gkgk0119gmail-arch/guardian-tron/sw/jetson_stack/docs/CARLA_SIL.md

# The gatekeeper in CARLA, before it went on the car

Before there was a board, we drove the gatekeeper in [CARLA](https://carla.org/): a
simulated car with a 64-channel LiDAR, the same 15-byte CMD frames at 100 Hz, and an
attacker injecting steering commands into the link. The point was to answer one question
without risking a real vehicle — **does this veto logic actually stop an attack, and what
happens when it is not there?**

The simulator settled the *decision*. The board later settled the *timing*: the same logic
running on μT-Kernel 3.0 on the STM32N6570-DK, measured with the DWT cycle counter at
1.25 ns resolution ([test report](../../docs/test_report.md)).

Every counter in the screenshots below is measured output from those runs — approvals,
vetoes, collisions and lane departures were counted by the simulation, not drawn by hand.

## Reading the screenshots

The on-screen HUD is in Korean, because it was our working tool. By position:

| Where | What it shows |
|---|---|
| Top-left box | the scenario, whether the gatekeeper is enabled, and the simulation time |
| Top-right badge | the verdict at that instant — green APPROVE, red VETO → FAILSAFE, red "attack passes" when the gatekeeper is disabled, amber "inside the envelope" |
| Line under the badge | steering **commanded** by the AI → steering **applied** after the gatekeeper, and the veto reason when there is one |
| Upper-left stats | speed, lateral offset from the lane centre, LiDAR points per frame, vehicles detected, cumulative approved / vetoed, collisions / lane departures |
| Lower-left list | detected vehicles by distance, with the number of LiDAR points on each |
| Coloured points | height above ground; cyan is the road surface |
| Green box / red box | a vehicle found in the point cloud / the ego vehicle |
| Inset, bottom right | RGB chase camera |
| Banner across the inset | the attack currently being injected |

## Normal driving

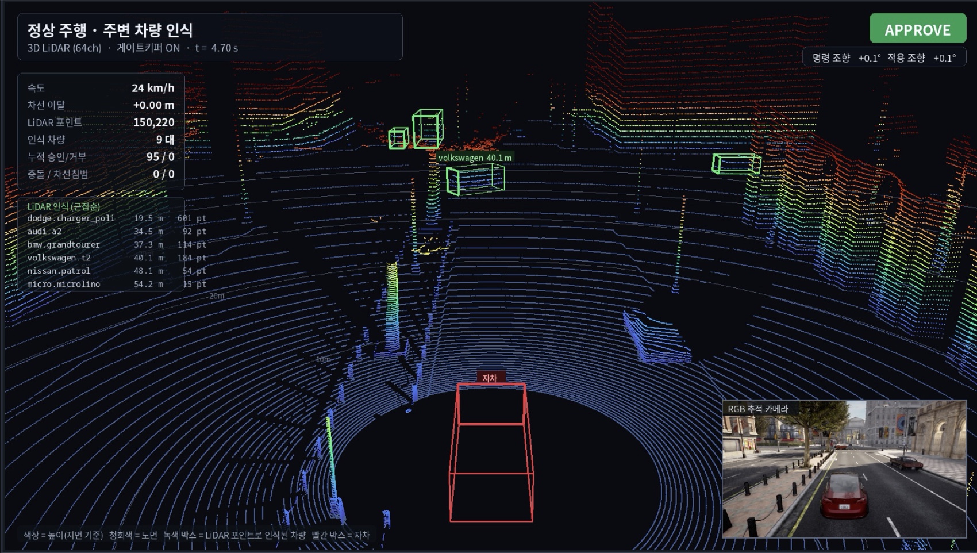
[picture p14: sw/jetson_stack/docs/carla/carla_normal.jpg]
CARLA, normal driving: the gatekeeper approves every command


Gatekeeper enabled, no attack. 95 commands approved, 0 vetoed, 0 collisions, 0 lane
departures, commanded steering +0.1° passed through as +0.1°. The gatekeeper is invisible
when nothing is wrong — that was the first thing worth confirming, because a safety layer
that interferes with normal driving does not get deployed.

## Three threats, with and without the gatekeeper

CARLA, four cases side by side at t = 6.45 s

All four panels are the same scenario at the same instant, t = 6.45 s:

| Case | Gatekeeper | Commanded → applied | Result |
|---|---|---|---|
| Normal driving | on | +0.0° → +0.0° | APPROVE · 130/0 · **0 collisions, 0 lane departures** |
| **Threat ① adversarial perception** (full-lock injection) | on | **−540.0° → −5.4°** | **VETO → FAILSAFE**, reason `STEER_RATE` · 110/20 · **0 collisions, 0 lane departures** |
| **Threat ③ tampered firmware** (gatekeeper disabled) + ① | off | −540.0° → **−540.0°** | attack passes · lateral offset **+2.84 m** · **7 lane departures** |
| **Threat ② CAN stealth drift** (slow offset accumulation) | on | −1.0° → −1.0° | APPROVE — **inside the envelope** · lateral offset −0.80 m · 1 lane departure |

The first two rows are the result we were after: a full-lock steering injection of −540° is
clamped to −5.4° by the rate limiter and the car stays in its lane, while the identical
attack against a car whose gatekeeper has been disabled produces 7 lane departures within
the same few seconds.

The last row is the honest one. Threat ② does not jam the steering; it adds about −0.0035°
per frame, so every single command is legal and the gatekeeper approves all of them. The
car drifts anyway. A command-envelope check cannot catch an attack that stays inside the
envelope — this is the limitation that pushed us to give the STM32 **its own sensors**, so
that the version on the car does not depend only on judging the commands it is sent. The
camera + NPU person stop and the IMU tilt monitor in the shipped firmware both came out of
this.

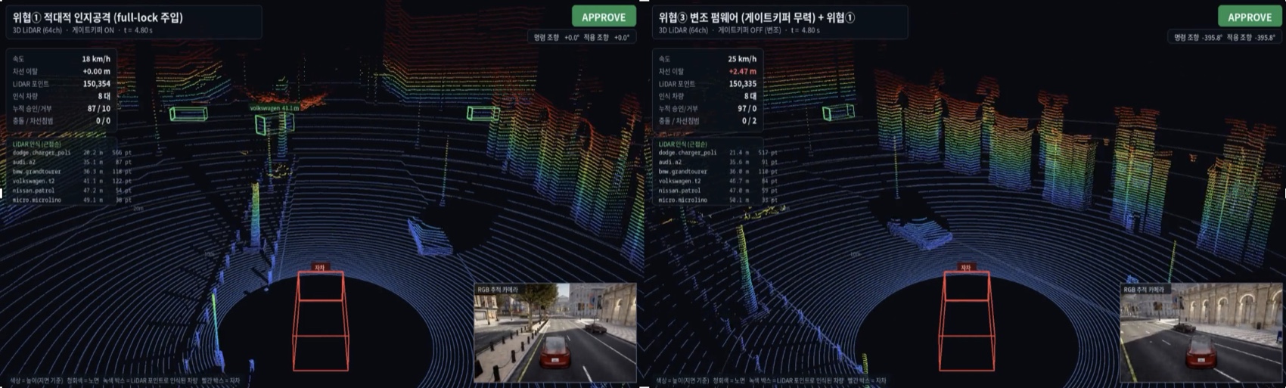
[picture p15: sw/jetson_stack/docs/carla/carla_threat_pair.jpg]
CARLA, threat ① with the gatekeeper enabled, and threat ③ with it disabled


## What carried over to the board

This is what makes it sim-to-real rather than two separate projects:

| | In CARLA | On the STM32N6570-DK |
|---|---|---|
| `gatekeeper_core.c` | the veto state machine | **byte-identical** ([`sw/guardian_vision/gt/`](../../guardian_vision/gt/)) |
| `protocol.c` | 15-byte CMD / 12-byte VERDICT, CRC8, sequence | **byte-identical** |
| `safety_envelope.c` | generic limits (±540°, rate limit 10° per command) | same code path, **retuned to this car**: `GK_STEER_ABS_LIMIT_DEG 17.5f`, `GK_STEER_RATE_LIMIT_DEG 3.0f` (300 °/s) |
| What was measured | the decision: approvals, vetoes, collisions, lane departures | the decision **and** its cost in time: command verdict **13.4 µs** max over 43 119 commands |
| Scheduling | one Linux process | 5 μT-Kernel tasks at fixed priorities, preemptive |
| Hazard source | injected by the threat scripts | real: camera + NPU, IMU, link watchdog |

The `STEER_RATE` veto in the second panel above is the same check that runs on the board
today; only the constant changed, because this car's steering is mechanically limited to
±17.5°.

## Scope of this page

- The CARLA integration itself — the simulator client, the LiDAR rendering and the HUD — is
  **not in this repository**. It is not needed to build, flash or evaluate the firmware.
  What is here is the gatekeeper logic it drove ([`../gatekeeper/`](../gatekeeper/)) and the
  threat scripts ([`../jetson/threats/`](../jetson/threats/)).
- The counters above are real measurements of the simulated vehicle. The timing figures in
  the [README](../../../README.md) and the [test report](../../docs/test_report.md) are a
  separate matter: those were all taken on the real board with the DWT cycle counter, and
  none of them comes from simulation.
