gkgk0119gmail-arch/guardian-tron/prj_stm32n6_cam/FSBL/Core/Src/main.c

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
/* Includes ------------------------------------------------------------------*/
#include "main.h"

/* USER CODE BEGIN Includes */
#include "isp_api.h"
#include "imx335_E27_isp_param_conf.h"
/* USER CODE END Includes */


DCMIPP_HandleTypeDef hdcmipp;
LTDC_HandleTypeDef hltdc;
ISP_HandleTypeDef  hcamera_isp;
/* USER CODE BEGIN PV */
static __IO uint32_t NbMainFrames = 0;
static IMX335_Object_t   IMX335Obj;
static int32_t isp_gain;
static int32_t isp_exposure;
/* USER CODE END PV */

void SystemClock_Config(void);
static void MX_DCMIPP_Init(void);
static void LCD_Init(uint32_t Width, uint32_t Height);
/* USER CODE BEGIN PFP */
static void IMX335_Probe(uint32_t Resolution, uint32_t PixelFormat);
static ISP_StatusTypeDef GetSensorInfoHelper(uint32_t Instance, ISP_SensorInfoTypeDef *SensorInfo);
static ISP_StatusTypeDef SetSensorGainHelper(uint32_t Instance, int32_t Gain);
static ISP_StatusTypeDef GetSensorGainHelper(uint32_t Instance, int32_t *Gain);
static ISP_StatusTypeDef SetSensorExposureHelper(uint32_t Instance, int32_t Exposure);
static ISP_StatusTypeDef GetSensorExposureHelper(uint32_t Instance, int32_t *Exposure);
/* USER CODE END PFP */

/**
  * @brief  The application entry point.
  * @retval int
  */
int main(void)
{

  /* USER CODE BEGIN 1 */
  ISP_AppliHelpersTypeDef appliHelpers = {0};
  /* USER CODE END 1 */

  /* Enable the CPU Cache */

  /* Enable I-Cache---------------------------------------------------------*/
  // SCB_EnableICache();

  /* Enable D-Cache---------------------------------------------------------*/
  // SCB_EnableDCache();

  /* MCU Configuration--------------------------------------------------------*/
  HAL_Init();

  /* Configure the system clock */
  SystemClock_Config();

  /* USER CODE BEGIN SysInit */
  BSP_LED_Init(LED_GREEN);
  BSP_LED_Init(LED_RED);
  BSP_PB_Init(BUTTON_USER1, BUTTON_MODE_EXTI);
    /* UART log */
#if USE_COM_LOG
  COM_InitTypeDef COM_Init;

  /* Initialize COM init structure */
  COM_Init.BaudRate   = 115200;
  COM_Init.WordLength = COM_WORDLENGTH_8B;
  COM_Init.StopBits   = COM_STOPBITS_1;
  COM_Init.Parity     = COM_PARITY_NONE;
  COM_Init.HwFlowCtl  = COM_HWCONTROL_NONE;

  BSP_COM_Init(COM1, &COM_Init);

  if (BSP_COM_SelectLogPort(COM1) != BSP_ERROR_NONE)
  {
    Error_Handler();
  }
#endif
  /* USER CODE END SysInit */

  /* Initialize all configured peripherals */
  MX_DCMIPP_Init();

  /* Initialize the IMX335 Sensor ----------------------------- */
  IMX335_Probe(IMX335_R2592_1944, IMX335_RAW_RGGB10);

  /* USER CODE BEGIN 2 */
  LCD_Init(FRAME_WIDTH, FRAME_HEIGHT);

  /* Fill init struct with Camera driver helpers */
  appliHelpers.GetSensorInfo = GetSensorInfoHelper;
  appliHelpers.SetSensorGain = SetSensorGainHelper;
  appliHelpers.GetSensorGain = GetSensorGainHelper;
  appliHelpers.SetSensorExposure = SetSensorExposureHelper;
  appliHelpers.GetSensorExposure = GetSensorExposureHelper;

  /* Initialize the Image Signal Processing middleware */
  if(ISP_Init(&hcamera_isp, &hdcmipp, 0, &appliHelpers, ISP_IQParamCacheInit[0]) != ISP_OK)
  {
    Error_Handler();
  }

  if (HAL_DCMIPP_CSI_PIPE_Start(&hdcmipp, DCMIPP_PIPE1, DCMIPP_VIRTUAL_CHANNEL0 , BUFFER_ADDRESS, DCMIPP_MODE_CONTINUOUS) != HAL_OK)
  {
    Error_Handler();
  }

  /* Start the Image Signal Processing */
  if (ISP_Start(&hcamera_isp) != ISP_OK)
  {
    Error_Handler();
  }

  void knl_start_mtkernel(void);
  knl_start_mtkernel();
  /* USER CODE END 2 */

  /* Infinite loop */
  /* USER CODE BEGIN WHILE */
  while (1)
  {
    /* USER CODE END WHILE */
    BSP_LED_Toggle(LED_GREEN);
    if (ISP_BackgroundProcess(&hcamera_isp) != ISP_OK)
    {
      BSP_LED_Toggle(LED_RED);
    }
    /* USER CODE BEGIN 3 */
  }
  /* USER CODE END 3 */
}

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
/* USER CODE BEGIN 4 */
/**
  * @brief  Register Bus IOs if component ID is OK
  * @retval error status
  */
static void IMX335_Probe(uint32_t Resolution, uint32_t PixelFormat)
{
  IMX335_IO_t              IOCtx;
  uint32_t                 id;

  /* Configure the camera driver */
  IOCtx.Address     = CAMERA_IMX335_ADDRESS;
  IOCtx.Init        = BSP_I2C1_Init;
  IOCtx.DeInit      = BSP_I2C1_DeInit;
  IOCtx.ReadReg     = BSP_I2C1_ReadReg16;
  IOCtx.WriteReg    = BSP_I2C1_WriteReg16;
  IOCtx.GetTick     = BSP_GetTick;

  if (IMX335_RegisterBusIO(&IMX335Obj, &IOCtx) != IMX335_OK)
  {
    Error_Handler();
  }
  else if (IMX335_ReadID(&IMX335Obj, &id) != IMX335_OK)
  {
    Error_Handler();
  }
  else
  {
    if (id != (uint32_t) IMX335_CHIP_ID)
    {
      Error_Handler();
    }
    else
    {
      if (IMX335_Init(&IMX335Obj, Resolution, PixelFormat) != IMX335_OK)
      {
        Error_Handler();
      }
      else if(IMX335_SetFrequency(&IMX335Obj, IMX335_INCK_24MHZ)!= IMX335_OK)
      {
        Error_Handler();
      }
      else
      {
        return;
      }
    }
  }
}

/**
  * @brief  ISP Middleware helper. Camera sensor info getter
  * @retval ISP Status
  */
static ISP_StatusTypeDef GetSensorInfoHelper(uint32_t Instance, ISP_SensorInfoTypeDef *SensorInfo)
{
  UNUSED(Instance);
  return (ISP_StatusTypeDef) IMX335_GetSensorInfo(&IMX335Obj, (IMX335_SensorInfo_t *) SensorInfo);
}

/**
  * @brief  ISP Middleware helper. Camera gain setter
  * @retval ISP Status
  */
static ISP_StatusTypeDef SetSensorGainHelper(uint32_t Instance, int32_t Gain)
{
  UNUSED(Instance);
  isp_gain = Gain;
  return (ISP_StatusTypeDef) IMX335_SetGain(&IMX335Obj, Gain);
}

/**
  * @brief  ISP Middleware helper. Camera gain getter
  * @retval ISP Status
  */
static ISP_StatusTypeDef GetSensorGainHelper(uint32_t Instance, int32_t *Gain)
{
  UNUSED(Instance);
  *Gain = isp_gain;
  return ISP_OK;
}

/**
  * @brief  ISP Middleware helper. Camera exposure setter
  * @retval ISP Status
  */
static ISP_StatusTypeDef SetSensorExposureHelper(uint32_t Instance, int32_t Exposure)
{
  UNUSED(Instance);
  isp_exposure = Exposure;
  return (ISP_StatusTypeDef) IMX335_SetExposure(&IMX335Obj, Exposure);
}

/**
  * @brief  ISP Middleware helper. Camera exposure getter
  * @retval ISP Status
  */
static ISP_StatusTypeDef GetSensorExposureHelper(uint32_t Instance, int32_t *Exposure)
{
  UNUSED(Instance);
  *Exposure = isp_exposure;
  return ISP_OK;
}

void HAL_DCMIPP_PIPE_FrameEventCallback(DCMIPP_HandleTypeDef *hdcmipp, uint32_t Pipe)
{
  NbMainFrames++;
}

/**
 * @brief  Vsync Event callback on pipe
 * @param  hdcmipp DCMIPP device handle
 *         Pipe    Pipe receiving the callback
 * @retval None
 */
void HAL_DCMIPP_PIPE_VsyncEventCallback(DCMIPP_HandleTypeDef *hdcmipp, uint32_t Pipe)
{
  UNUSED(hdcmipp);
  /* Update the frame counter and call the ISP statistics handler */
  switch (Pipe)
  {
    case DCMIPP_PIPE0 :
      ISP_IncDumpFrameId(&hcamera_isp);
      break;
    case DCMIPP_PIPE1 :
      ISP_IncMainFrameId(&hcamera_isp);
      ISP_GatherStatistics(&hcamera_isp);
      break;
    case DCMIPP_PIPE2 :
      ISP_IncAncillaryFrameId(&hcamera_isp);
      break;
  }
}

/* USER CODE END 4 */
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
