gkgk0119gmail-arch/guardian-tron/mtk3bsp2_stm32n657/FSBL/Core/Inc/main.h

#define OSC_IN_Pin GPIO_PIN_0
#define OSC_IN_GPIO_Port GPIOH
#define SD_D0_Pin GPIO_PIN_4
#define SD_D0_GPIO_Port GPIOC
#define MIC_D1_Pin GPIO_PIN_8
#define MIC_D1_GPIO_Port GPIOE
#define LCD_B4_Pin GPIO_PIN_3
#define LCD_B4_GPIO_Port GPIOH
#define LCD_B5_Pin GPIO_PIN_6
#define LCD_B5_GPIO_Port GPIOH
#define OSC_OUT_Pin GPIO_PIN_1
#define OSC_OUT_GPIO_Port GPIOH
#define SD_D1_Pin GPIO_PIN_5
#define SD_D1_GPIO_Port GPIOC
#define LCD_R2_Pin GPIO_PIN_15
#define LCD_R2_GPIO_Port GPIOD
#define I2C2_SDA_Pin GPIO_PIN_4
#define I2C2_SDA_GPIO_Port GPIOD
#define LCD_HSYNC_Pin GPIO_PIN_14
#define LCD_HSYNC_GPIO_Port GPIOB
#define SD_D2_Pin GPIO_PIN_0
#define SD_D2_GPIO_Port GPIOC
#define VCP_TX_Pin GPIO_PIN_5
#define VCP_TX_GPIO_Port GPIOE
#define I2C2_SCL_Pin GPIO_PIN_14
#define I2C2_SCL_GPIO_Port GPIOD
#define LCD_B2_Pin GPIO_PIN_2
#define LCD_B2_GPIO_Port GPIOB
#define SD_CK_Pin GPIO_PIN_2
#define SD_CK_GPIO_Port GPIOC
#define SD_D3_Pin GPIO_PIN_4
#define SD_D3_GPIO_Port GPIOE
#define VCP_RX_Pin GPIO_PIN_6
#define VCP_RX_GPIO_Port GPIOE
#define LCD_G4_Pin GPIO_PIN_15
#define LCD_G4_GPIO_Port GPIOB
#define SD_CMD_Pin GPIO_PIN_3
#define SD_CMD_GPIO_Port GPIOC
#define LCD_VSYNC_Pin GPIO_PIN_11
#define LCD_VSYNC_GPIO_Port GPIOE
#define LCD_R7_Pin GPIO_PIN_8
#define LCD_R7_GPIO_Port GPIOD
#define SAI1_FS_A_Pin GPIO_PIN_0
#define SAI1_FS_A_GPIO_Port GPIOB
#define SAI1_SD_A_Pin GPIO_PIN_7
#define SAI1_SD_A_GPIO_Port GPIOB
#define SAI1_CLK_A_Pin GPIO_PIN_6
#define SAI1_CLK_A_GPIO_Port GPIOB
#define User_Pin GPIO_PIN_13
#define User_GPIO_Port GPIOC
#define LCD_R4_Pin GPIO_PIN_4
#define LCD_R4_GPIO_Port GPIOH
#define SAI1_SD_B_Pin GPIO_PIN_3
#define SAI1_SD_B_GPIO_Port GPIOE
#define MIC_CK_Pin GPIO_PIN_2
#define MIC_CK_GPIO_Port GPIOE
#define TAMP_Pin GPIO_PIN_0
#define TAMP_GPIO_Port GPIOE
#define HEXASPI_IO_7_Pin GPIO_PIN_7
#define HEXASPI_IO_7_GPIO_Port GPIOP
#define HEXASPI_IO_6_Pin GPIO_PIN_6
#define HEXASPI_IO_6_GPIO_Port GPIOP
#define HEXASPI_IO_0_Pin GPIO_PIN_0
#define HEXASPI_IO_0_GPIO_Port GPIOP
#define LCD_R1_Pin GPIO_PIN_9
#define LCD_R1_GPIO_Port GPIOD
#define HEXASPI_IO_4_Pin GPIO_PIN_4
#define HEXASPI_IO_4_GPIO_Port GPIOP
#define HEXASPI_IO_1_Pin GPIO_PIN_1
#define HEXASPI_IO_1_GPIO_Port GPIOP
#define HEXASPI_IO_15_Pin GPIO_PIN_15
#define HEXASPI_IO_15_GPIO_Port GPIOP
#define HEXASPI_IO_5_Pin GPIO_PIN_5
#define HEXASPI_IO_5_GPIO_Port GPIOP
#define HEXASPI_IO_12_Pin GPIO_PIN_12
#define HEXASPI_IO_12_GPIO_Port GPIOP
#define HEXASPI_IO_3_Pin GPIO_PIN_3
#define HEXASPI_IO_3_GPIO_Port GPIOP
#define HEXASPI_IO_2_Pin GPIO_PIN_2
#define HEXASPI_IO_2_GPIO_Port GPIOP
#define HEXASPI_IO_13_Pin GPIO_PIN_13
#define HEXASPI_IO_13_GPIO_Port GPIOP
#define HEXASPI_DQS0_Pin GPIO_PIN_2
#define HEXASPI_DQS0_GPIO_Port GPIOO
#define SAI1_MCLK_A_Pin GPIO_PIN_7
#define SAI1_MCLK_A_GPIO_Port GPIOG
#define LCD_B3_Pin GPIO_PIN_6
#define LCD_B3_GPIO_Port GPIOG
#define HEXASPI_IO_11_Pin GPIO_PIN_11
#define HEXASPI_IO_11_GPIO_Port GPIOP
#define HEXASPI_IO_8_Pin GPIO_PIN_8
#define HEXASPI_IO_8_GPIO_Port GPIOP
#define HEXASPI_IO_14_Pin GPIO_PIN_14
#define HEXASPI_IO_14_GPIO_Port GPIOP
#define HEXASPI_DQS1_Pin GPIO_PIN_3
#define HEXASPI_DQS1_GPIO_Port GPIOO
#define HEXASPI_NCS_Pin GPIO_PIN_0
#define HEXASPI_NCS_GPIO_Port GPIOO
#define HEXASPI_IO_9_Pin GPIO_PIN_9
#define HEXASPI_IO_9_GPIO_Port GPIOP
#define HEXASPI_IO_10_Pin GPIO_PIN_10
#define HEXASPI_IO_10_GPIO_Port GPIOP
#define HEXASPI_CLK_Pin GPIO_PIN_4
#define HEXASPI_CLK_GPIO_Port GPIOO
#define OCTOSPI_IO2_Pin GPIO_PIN_4
#define OCTOSPI_IO2_GPIO_Port GPION
#define LCD_G2_Pin GPIO_PIN_1
#define LCD_G2_GPIO_Port GPIOA
#define LCD_G6_Pin GPIO_PIN_11
#define LCD_G6_GPIO_Port GPIOB
#define LCD_R5_Pin GPIO_PIN_15
#define LCD_R5_GPIO_Port GPIOA
#define OCTOSPI_CLK_Pin GPIO_PIN_6
#define OCTOSPI_CLK_GPIO_Port GPION
#define OCTOSPI_IO4_Pin GPIO_PIN_8
#define OCTOSPI_IO4_GPIO_Port GPION
#define OCTOSPI_DQS_Pin GPIO_PIN_0
#define OCTOSPI_DQS_GPIO_Port GPION
#define LCD_B0_Pin GPIO_PIN_15
#define LCD_B0_GPIO_Port GPIOG
#define LCD_G1_Pin GPIO_PIN_1
#define LCD_G1_GPIO_Port GPIOG
#define LCD_G5_Pin GPIO_PIN_12
#define LCD_G5_GPIO_Port GPIOB
#define LCD_B1_Pin GPIO_PIN_7
#define LCD_B1_GPIO_Port GPIOA
#define LCD_R0_Pin GPIO_PIN_0
#define LCD_R0_GPIO_Port GPIOG
#define OCTOSPI_IO1_Pin GPIO_PIN_3
#define OCTOSPI_IO1_GPIO_Port GPION
#define OCTOSPI_IO3_Pin GPIO_PIN_5
#define OCTOSPI_IO3_GPIO_Port GPION
#define OCTOSPI_NCS_Pin GPIO_PIN_1
#define OCTOSPI_NCS_GPIO_Port GPION
#define SWCLK_Pin GPIO_PIN_14
#define SWCLK_GPIO_Port GPIOA
#define LCD_B7_Pin GPIO_PIN_2
#define LCD_B7_GPIO_Port GPIOA
#define LCD_G0_Pin GPIO_PIN_12
#define LCD_G0_GPIO_Port GPIOG
#define LCD_R3_Pin GPIO_PIN_4
#define LCD_R3_GPIO_Port GPIOB
#define LCd_G7_Pin GPIO_PIN_8
#define LCd_G7_GPIO_Port GPIOG
#define OCTOSPI_IO5_Pin GPIO_PIN_9
#define OCTOSPI_IO5_GPIO_Port GPION
#define OCTOSPI_IO0_Pin GPIO_PIN_2
#define OCTOSPI_IO0_GPIO_Port GPION
#define SWDIO_Pin GPIO_PIN_13
#define SWDIO_GPIO_Port GPIOA
#define LCD_DE_Pin GPIO_PIN_13
#define LCD_DE_GPIO_Port GPIOG
#define LCD_G3_Pin GPIO_PIN_0
#define LCD_G3_GPIO_Port GPIOA
#define SWO_Pin GPIO_PIN_5
#define SWO_GPIO_Port GPIOB
#define LCD_R6_Pin GPIO_PIN_11
#define LCD_R6_GPIO_Port GPIOG
#define OCTOSPI_IO6_Pin GPIO_PIN_10
#define OCTOSPI_IO6_GPIO_Port GPION
#define OCTOSPI_IO7_Pin GPIO_PIN_11
#define OCTOSPI_IO7_GPIO_Port GPION
