gkgk0119gmail-arch/guardian-tron/(commit log)

2026-09-17 Guardian-TRON: initial import of STM32 μT-Kernel firmware, Jetson stack and docs skeleton
2026-09-21 HIBIKI / Guardian-TRON: μT-Kernel 3.0 firmware, measurements and submission docs
    - Restructure into hw/ (BOM, wiring, photos) and sw/ (firmware, Jetson stack,
    tools, binaries, results, docs)
    - STM32 firmware (sw/guardian_vision): gatekeeper, camera + NPU person stop with
    distance-graded speed cap, 100 Hz IMU Kalman monitor, MPU isolation, dispatch
    hook (per-task CPU, metrics with percentiles), non-blocking logger,
    interrupt-driven UART TX, 1 ms tick, link-loss watchdog
    - Boot from flash: signed + aligned image, flash_boot.sh
    - Evaluation: pc_host.py Jetson stand-in with fault scenarios, run_demo.sh
    --stress/--freeze, Linux jitter probe, measured results in sw/results
    - Docs: setup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
    [latency_results.csv, memory_results.csv, metrics.csv]
2026-09-21 Translate remaining Korean text to English; English BOM image
2026-09-21 README: main photo and numbered BOM image
2026-09-21 Add measurement graphs (make_figures.py) and filming runs to results
    [metrics.csv]
2026-09-21 README quick start for judges and hibiki_eval.py evaluator
    - Step-by-step setup for Windows, macOS and Linux (Python venv, pyserial)
    - sw/examples/hibiki_eval.py: judges every claim (RTOS timing, NPU person
    stop, speed cap, IMU, MPU, watchdog, command checks) from a live board or a
    recorded console log; PASS / FAIL / NOT RUN table and saved report
    - Three levels: no hardware (recorded logs), the board, board + USB-TTL with
    the PC playing the Jetson and injecting faults
    - pc_host.py: scenarios callable as a function (run_scenario)
    - sw/requirements.txt
    - Known issue documented: rare monitor jitter spikes (max 817 us, 0.017 % of
    121k periods) in the long floor runs, likely caused by th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
    [hibiki_eval.py, pc_host.py]
2026-09-21 Car runbook in README, hibiki.sh, colour wiring map, jitter fix
    - README: replace the level/step guide with one run on the car: laptop setup,
    Jetson Wi-Fi + hostname -I, ssh, two terminals, what to do and what to see
    - sw/jetson_stack/ros2/hibiki.sh: start / arm / disarm / stress / freeze /
    status / stop on the Jetson
    - hibiki_eval.py --watch: watch the board while driving, report on Ctrl+C or
    SIGTERM
    - hw/wiring.md: cable colours as built (green/white/black USB-TTL,
    red/brown/black VESC)
    - Firmware: console reports moved from the gate task (pri 8) to a report task
    (pri 25). Removes the rare monitor jitter spikes: 0 of 141 054 periods over
    100 us, max 12.5 us (was 817 us). Binari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
    [gt_gate.c, gt_gate.h, hibiki_eval.py, usermain.c]
2026-09-21 README: Windows PowerShell steps; evaluator safe on non-UTF-8 consoles
2026-09-25 Add LICENSE, cable colour map figure, and sync docs with the fixed firmware
    - LICENSE: MIT for the team's code, with the third-party licenses named
    (T-License 2.2 for micro T-Kernel, BSD-3/Apache-2.0/SLA0044 for ST and Arm)
    - hw/photos/pinmap.svg: cable colour map (green/white/black to the USB-TTL,
    red/brown/black to the VESC), linked from hw/README.md and hw/wiring.md
    - All measurements now come from run_J, the run recorded with the current
    flashed firmware: jitter 11.9 us over 80,932 periods (99.6 % below Linux
    under load), interrupt to task 9.5 us over 695,600, command verdict 13.4 us
    over 43,119, hazard to brake 34 us over 66 events, safety CPU 3.2 %
    - Documents follow the code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
    [latency_results.csv, memory_results.csv]
2026-09-25 README: restore the cross-platform install block (the PowerShell-only steps stay below)
2026-09-25 docs: safety-task CPU is 3.4 % (gate 0.2 + imu 3.2), not 3.2 %
2026-09-25 docs: sync the Jetson-side docs with the finished system and fix stale numbers
    - jetson_stack/README.md described the software-in-the-loop phase and said the
    uT-Kernel port was not done; rewritten around ros2/ and bench/, which is what
    the car actually runs
    - STM32_PORT.md and WIRING.md marked historical, with a table mapping every open
    item to where it was built
    - README mermaid: envelope 13.4 us, hazard -> brake 34 us (run J, not the old run A)
    - evaluation_guide: the metric block is now run J verbatim, with the pooled
    hazard and link-loss counts explained
    - linux_jitter_jetson.txt: note that the earlier session's console output was not saved
2026-09-26 README: note that the board was powered from a laptop USB-C during development
    The buck converter in the power path is the untethered on-device configuration.
    Every measurement was recorded with the board on the ST-LINK USB-C port instead,
    because that cable carries power, the console and the flash link at once.
2026-09-26 Add the CARLA simulation work that preceded the board
    The veto logic was driven against a simulated car with an attacker injecting
    steering before any hardware existed. Documents the three threat scenarios, what
    carried over byte-identical to the firmware, and the limitation (a drift that
    stays inside the envelope) that led to giving the STM32 its own sensors.
