gkgk0119gmail-arch/guardian-tron/(notices)

Notices in the files:
mtk3bsp2_stm32n657/FSBL/Core/Inc/main.h:
Copyright (c) 2026 STMicroelectronics.
All rights reserved.
